austintgriffith/picowallet/pcb/v0/render/pcb.png

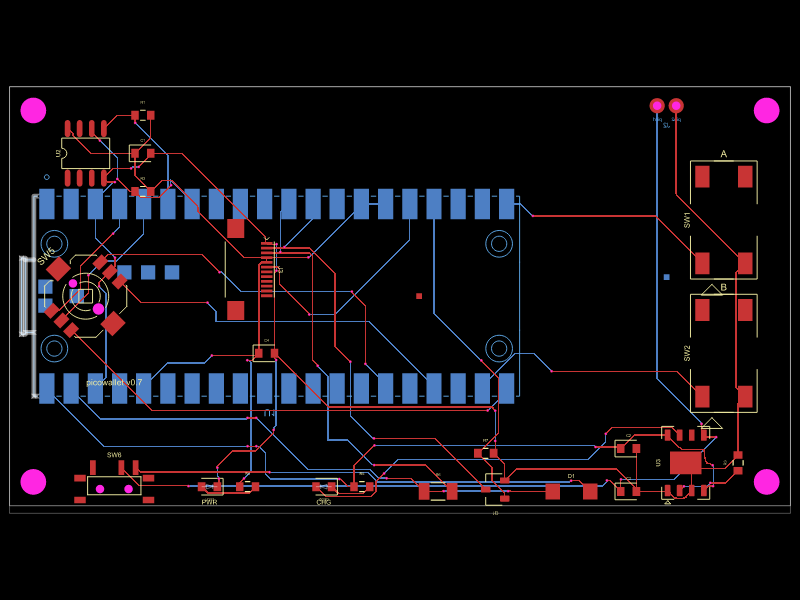
pcb/v0/render/pcb.png
