austintgriffith/picowallet/pcb/COST.md

# picowallet one-board v0.2 — cost + risk (2026-09-23)

Design: `pcb/v0/index.circuit.tsx`. Fab files: `pcb/v0/fab.zip`. Live 3D: see the artifact link in the session.

## Cost, 5 boards (estimate, JLCPCB quote decides)

| Item | Note | USD |
|---|---|---|
| Parts from LCSC | Pico 2 W is $14.20 there (5× = $71). Everything else ~$2.50/board | 84 |
| Bare PCBs | 5 pcs, 2 layer, 64×46 mm | 5 |
| Assembly setup | Parts on both sides = "standard" assembly, $50 flat. One side = $0 | 50 |
| Feeder fees | 6 non-basic part types × $3 | 18 |
| Hand-soldered THT | JST plug + screen header | 6 |
| Shipping | DHL. Slow post ~$10 | 25 |
| **JLCPCB order** | 5 assembled boards | **≈190** |
| Screens | 5× 1.3" ST7789 240×240 module, Amazon | 20 |
| Batteries | 5× 500 mAh LiPo with protection, JST-PH | 30 |
| **Everything** | 5 wallets, ~$48 each | **≈240** |

Cuts: buy Picos at $7 retail and solder them ourselves (−$36). Put only joystick + 2 buttons on the front and hand-solder those (one-sided assembly, −$50). Both → order ≈ $100.

## Confidence: ~80% the first batch runs the firmware with no board fix (net-by-net review 2026-09-23)

Ordered by how much it worries me:
1. ~~Pico footprint mirrored on the back~~ **Checked.** From the back, pin 1 is top-right with USB on the right, same as a real Pico. All 40 labels match the official pinout.
2. ~~Joystick~~ **Checked** (ALPS SKRH datasheet): pin 2 = center, pin 5 = common, both wired right. Directions are diagonal on the body, so SW5 is now at 45°. Up/down/left/right → A/B/C/D is a firmware table; `firmware/keytest.py` finds it.
3. **Screen header order** GND VCC SCL SDA RES DC CS BLK. Clones vary. Check the module you buy.
4. **Slide switch**: pad 2 is the middle pad and is wired as common, standard SPDT. Datasheet PDF blocked, so by geometry + convention.
5. **WiFi**: switch + battery plug sit near the Pico antenna end. Expect range loss, not a dead radio.
6. **No battery protection on board.** Buy protected LiPos. Charge current ~235 mA (R3 = 5.1k) for the 200 mAh 402030 cell.
7. **Thickness** ~17 mm with screen on the front and Pico on the back.
8. Nobody has powered one. Passed tscircuit netlist/placement/shorts only.

## Pins (unchanged from firmware)
LCD DC/CS/SCK/MOSI/RST/BL = GP8/9/10/11/12/13 · A/B = GP15/GP17 · joystick u/d/l/r/press = GP2/18/16/20/3 · ATECC SDA/SCL = GP4/5 · VSYS ← battery via switch + SS14 · TP4056 VCC ← VBUS.

## Net-by-net review 2026-09-23 (v0.4)
Dumped the compiled netlist and checked: all 40 Pico labels vs official pinout; Pico mirror (from the back, USB right, pin 1 top-right, pin 20 top-left = a real Pico rotated USB-right); ATECC608B SOIC-8 (4 GND, 5 SDA, 6 SCL, 8 VCC); TP4056 ESOP-8 (TEMP→GND disables thermistor, CE→VCC enables, PROG 5.1k ≈ 235 mA); SS14 anode←switch, cathode→VSYS (Pico datasheet battery hookup); J1 7-pin GND VCC SCL SDA RES DC BLK; J2 pin1 BAT+. All matched. Independent agent review was started but died on a spend limit before reporting.
