austintgriffith/picowallet/pcb/v0/bom.csv

Designator | Comment | Value | Footprint | JLCPCB Part #
U1 |  | C42394205 | C42394205 | C42394205
J3 |  | C466532 | C466532 | C466532
C4 | 100n | 100n | cap0603 | C14663
R6 | 39 | 39 | res1206 | C25379
Q1 |  | C20917 | sot23w_p1mm_pw0.65mm_pin1location(rightside,bottom) | C20917
R7 | 10k | 10k | res0603 | C25804
SW5 |  | C139794 | C139794 | C139794
SW1 |  | C2837531 | C2837531 | C2837531
SW2 |  | C2837531 | C2837531 | C2837531
U2 |  | C1518769 | C1518769 | C1518769
R1 | 4.7k | 4.7k | res0603 | C23162
R2 | 4.7k | 4.7k | res0603 | C23162
C1 | 100n | 100n | cap0603 | C14663
J2 |  | C131337 | C131337 | C131337
C2 | 10u | 10u | cap0603 | C19702
U3 |  | C725790 | C725790 | C725790
R3 | 12k | 12k | res0603 | C22790
C3 | 10u | 10u | cap0603 | C19702
D1 |  | C2480 | C2480 | C2480
SW6 |  | C431540 | C431540 | C431540
R10 | 100k | 100k | res0603 | C25803
Q2 |  | C15127 | sot23w_p1mm_pw0.65mm_pin1location(rightside,bottom) | C15127
R8 | 100k | 100k | res0603 | C25803
R9 | 10k | 10k | res0603 | C25804
LED1 |  | C12624 | 0603_color(green) | C12624
R4 | 1k | 1k | res0603 | C21190
LED2 |  | C2286 | 0603_color(red) | C2286
R5 | 1k | 1k | res0603 | C21190
