austintgriffith/picowallet/pcb/dossier/img/jlcpcb-bom-v07c.png

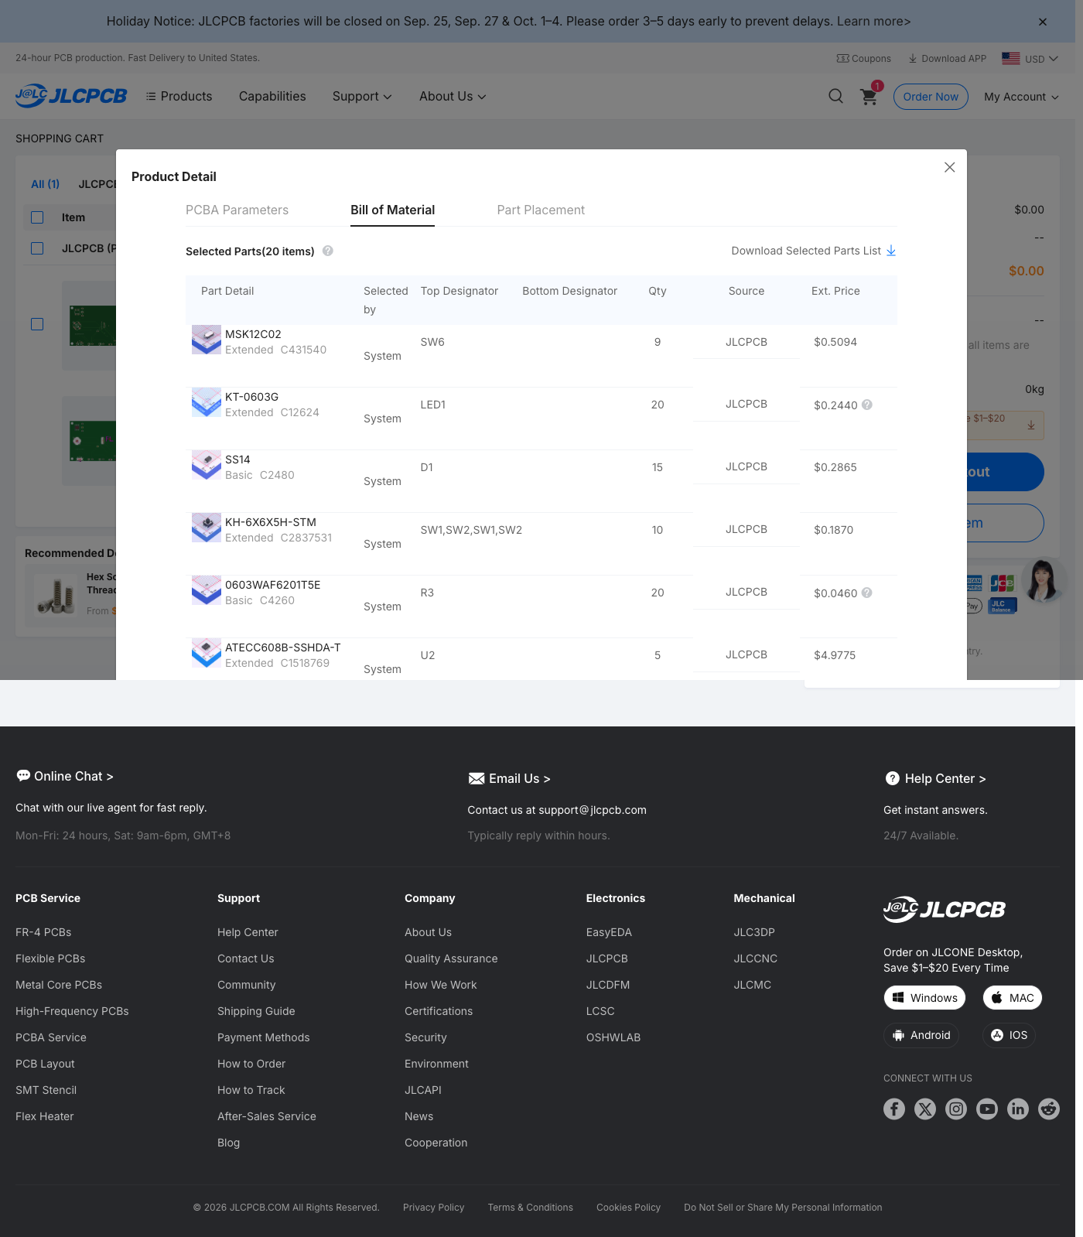
pcb/dossier/img/jlcpcb-bom-v07c.png
