austintgriffith/picowallet/buildlog/wiring-card.html

# Pico wallet: ATECC608 wires (the white/yellow/black/red bag)

The bag of white / yellow / black / red JST cables into the LCD board header, beside the Pico pins. USB at the top. Count down from the USB end.
Look at the Pico side of the sandwich, not the screen side. Checked 2026-09-26: two chips (ATECC608 on 9/14, Trust M on 9/17) answered with exactly this wiring.

Wire | Goes to | Side | From USB end | Pin #
White | GND | Right | 3rd | 38
Yellow | 3V3 OUT | Right | 5th | 36
Black | SDA (GP4) | Left | 6th | 6
Red | SCL (GP5) | Left | 7th | 7

Right side, top down: VBUS, VSYS, GND (white), 3V3_EN, 3V3 (yellow). Skip 1st, 2nd and 4th. Never put a wire in the 4th (3V3_EN): GND there shuts off 3.3 V.

Left side, top down: GP0, GP1, GND, GP2, GP3, GP4 (black), GP5 (red).

Push the bare ends into the LCD board's socket beside the Pico pins. Tug lightly. Jam the breakout flat in the gap.

Bare pins on the Pico itself are in the same order, board face up, USB at top.

Rule: the plug is GND, V+, SDA, SCL from the GND end. This bag colors that white, yellow, black, red. Trust the order, not the colors.
