austintgriffith/picowallet/pcb/dossier/review/KH6X6-manufacturer.pdf

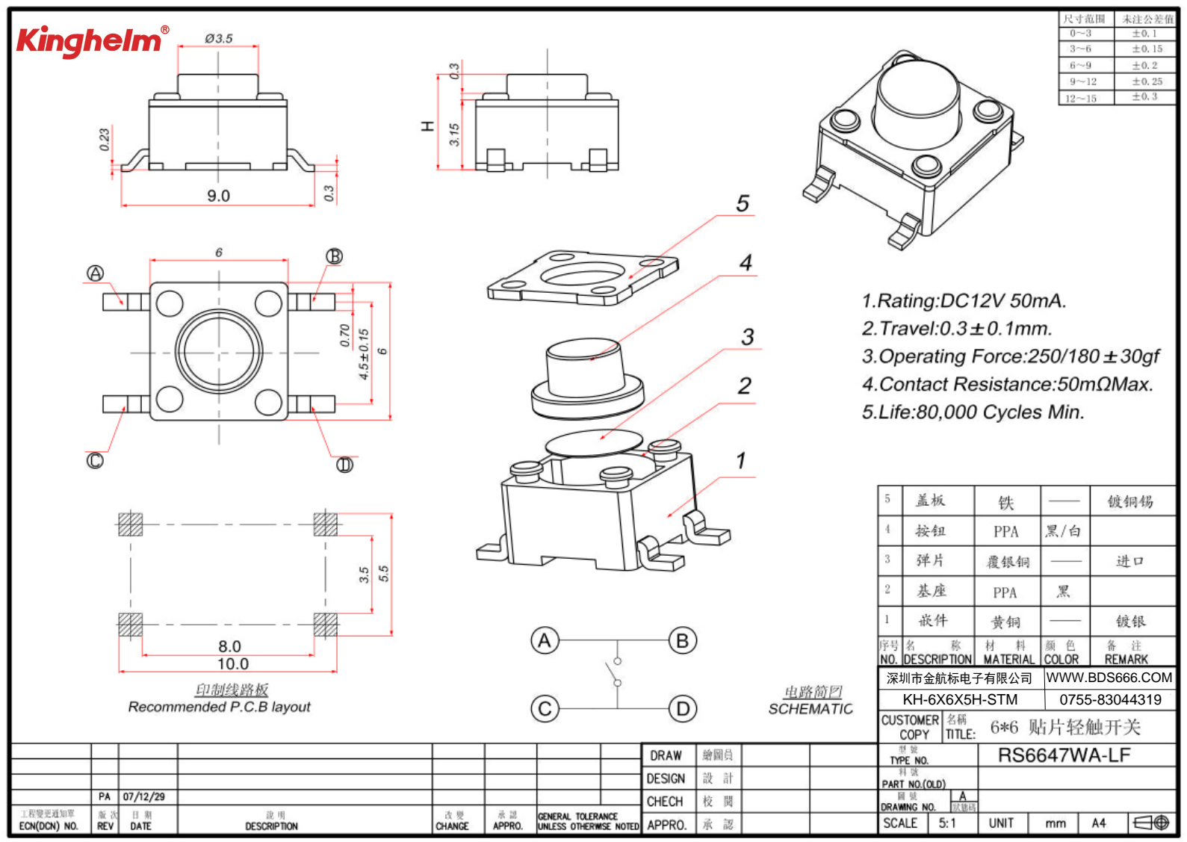
[picture p56: page 1]

深圳市金航标电子有限公司 WWW.BDS666.COM KH-6X6X5H-STM 0755-83044319
