austintgriffith/picowallet/pcb/dossier/review/copper-results.txt

Gerber objects 725
SHORTS 0
OPENS 0
J3 NET J3.1 GND ['U1.3', 'U1.38', 'J3.1', 'J3.12', 'C4.2', 'Q1.2', 'R7.2', 'SW5.5', 'SW1.2', 'SW2.2', 'U2.4', 'C1.2', 'J2.2', 'C2.2', 'U3.1', 'U3.3', 'U3.9', 'R3.2', 'C3.2', 'LED1.1']
J3 NET J3.2  ['U1.12', 'J3.2']
J3 NET J3.3  ['U1.11', 'J3.3']
J3 NET J3.4  ['U1.14', 'J3.4']
J3 NET J3.5  ['U1.15', 'J3.5']
J3 NET J3.6  ['U1.16', 'J3.6']
J3 NET J3.7  ['J3.7']
J3 NET J3.8 V3_3 ['U1.36', 'J3.8', 'J3.9', 'C4.1', 'U2.8', 'R1.2', 'R2.2', 'C1.1', 'R4.1']
J3 NET J3.9 V3_3 ['U1.36', 'J3.8', 'J3.9', 'C4.1', 'U2.8', 'R1.2', 'R2.2', 'C1.1', 'R4.1']
J3 NET J3.10  ['J3.10', 'R6.2']
J3 NET J3.11  ['J3.11', 'Q1.3']
J3 NET J3.12 GND ['U1.3', 'U1.38', 'J3.1', 'J3.12', 'C4.2', 'Q1.2', 'R7.2', 'SW5.5', 'SW1.2', 'SW2.2', 'U2.4', 'C1.2', 'J2.2', 'C2.2', 'U3.1', 'U3.3', 'U3.9', 'R3.2', 'C3.2', 'LED1.1']
J3 NET J3.13  ['J3.13']
J3 NET J3.14  ['J3.14']
Clearances <0.149 mm 43
0.102859 top [(-3.9415034999999996, -1.9111410000000002)] [(-3.9639999999999995, -2.2390000000000008)] ['U1.3', 'U1.38', 'J3.1'] ['J3.10', 'R6.2']
0.103567 top [(8.504393500000004, -14.664729499999995)] [(7.3489999999999975, -13.974000000000002)] ['U1.3', 'U1.38', 'J3.1'] ['U1.17', 'Q1.1', 'R7.1']
0.103861 bottom [(11.189963, -9.689973000000002)] [(10.377763999999997, -11.530716999999997)] ['U1.21', 'SW5.3'] ['U1.22', 'SW2.1']
0.104592 top [(6.4236895, -12.713803499999997)] [(6.9540000000000015, -12.777999999999997)] ['U1.3', 'U1.38', 'J3.1'] ['J3.11', 'Q1.3']
0.104731 bottom [(-34.530037, -9.689973)] [(-33.784088499999996, -13.090095499999997)] ['U1.39', 'R6.1', 'D1.1'] ['U1.40', 'C2.1', 'U3.4']
0.105716 top [(-32.4409075, 5.288795499999998)] [(-32.117, 5.145000000000002)] ['U1.4', 'SW5.1'] ['U1.3', 'U1.38', 'J3.1']
0.108653 top [(-3.0, -1.85)] [(-3.4275399999999996, -2.2071845000000008)] ['J3.11', 'Q1.3'] ['U1.3', 'U1.38', 'J3.1']
0.109792 bottom [(-31.990037000000004, -9.689973)] [(-33.070367000000005, -11.270974)] ['U1.3', 'U1.38', 'J3.1'] ['U1.39', 'R6.1', 'D1.1']
0.110747 top [(2.7464059999999826, -5.37058749999998)] [(-1.541999999999999, -1.5569999999999986)] ['J3.11', 'Q1.3'] ['U1.3', 'U1.38', 'J3.1']
0.113489 top [(-4.824999999999999, -20.0)] [(-5.1191935000000015, -20.66348899999999)] ['U1.40', 'C2.1', 'U3.4'] ['LED2.1', 'R5.2']
0.116818 top [(-3.0, 3.1499999999999995)] [(-3.6005009999999986, 2.9542289999999998)] ['U1.3', 'U1.38', 'J3.1'] ['U1.12', 'J3.2']
0.117378 top [(-3.0, -1.85)] [(-3.6469695, -1.9877550000000015)] ['J3.11', 'Q1.3'] ['U1.3', 'U1.38', 'J3.1']
0.118326 bottom [(-28.282627499999997, 7.202836500000004)] [(-29.625000000000004, 6.346)] ['U1.5', 'SW5.2'] ['U1.4', 'SW5.1']
0.123784 top [(7.062443999999995, -13.301677499999998)] [(6.939000000000003, -13.627999999999995)] ['U1.3', 'U1.38', 'J3.1'] ['J3.11', 'Q1.3']
0.125259 top [(7.3530000000000015, -12.925)] [(6.9540000000000015, -12.777999999999997)] ['U1.17', 'Q1.1', 'R7.1'] ['J3.11', 'Q1.3']
via drill sizes Counter({(0.3, 0.2): 62})
Minimum copper/rectangular edge clearance (0.24990000000000026, 94)
NPTH copper clearance (-31.656823091971688, -1.3435361182731562) [(0.6501637375312815, 31)]
NPTH copper clearance (-34.343715723395576, 1.3433565131507348) [(0.14347321315073483, 444)]
NPTH copper clearance (-31.5, -20.2502) [(1.104747572452157, 89)]
NPTH copper clearance (-28.5, -20.2502) [(0.5358015931360581, 116)]
NPTH copper clearance (-38.5, 19.5) [(2.177749408598903, 62)]
NPTH copper clearance (38.5, 19.5) [(4.642374675631586, 34)]
NPTH copper clearance (38.5, -19.5) [(1.2912740119706192, 83)]
NPTH copper clearance (-38.5, -19.5) [(2.950471998257225, 92)]
Min via hole edge spacing (0.2252175913576484, 'pcb_via_51', 'pcb_via_53')
NPTH closest copper object POLYGON ((-33.18999650000001 -0.7501255, -33.18999650000001 0.7498715, -34.6899935 0.7498715, -34.6899935 -0.7501255, -33.18999650000001 -0.7501255)) ['U1.46']
Via hole to foreign copper <.2 mm 21
(0.15285899999999986, 'pcb_via_56', 229, (-3.964, -2.239), 'top', ['U1.3', 'U1.38'])
(0.15356706537326545, 'pcb_via_50', 271, (7.349, -13.974), 'top', ['U1.3', 'U1.38'])
(0.15459237020598596, 'pcb_via_53', 268, (6.954, -12.778), 'top', ['U1.3', 'U1.38'])
(0.1557159628812923, 'pcb_via_30', 329, (-32.117, 5.145), 'top', ['U1.4', 'SW5.1'])
(0.1607470381618225, 'pcb_via_27', 345, (-1.542, -1.557), 'top', ['J3.11', 'Q1.3'])
(0.16832579811019183, 'pcb_via_49', 609, (-29.625, 6.346), 'bottom', ['U1.5', 'SW5.2'])
(0.17378295281951764, 'pcb_via_54', 270, (6.939, -13.628), 'top', ['U1.3', 'U1.38'])
(0.17524427172281387, 'pcb_via_51', 430, (7.353, -12.925), 'top', ['J3.11', 'Q1.3'])
Confirmed via hole to foreign TRACK violations 17
(0.15285899999999986, 'pcb_via_56', 229, (-3.964, -2.239), 'top', ['U1.3', 'U1.38']) Line(x1=-3.723583, y1=-1.911141, x2=-4.159424, y2=-1.911141, aperture=CircleAperture(unit=<LengthUnit millimeter>, attrs=(), original_number=10, _bounding_box=None, diameter=0.15, hole_dia=None), polarity_dark=True, unit=<LengthUnit millimeter>, attrs={})
(0.15356706537326545, 'pcb_via_50', 271, (7.349, -13.974), 'top', ['U1.3', 'U1.38']) Line(x1=7.183787, y1=-13.344123, x2=9.825, y2=-15.985336, aperture=CircleAperture(unit=<LengthUnit millimeter>, attrs=(), original_number=10, _bounding_box=None, diameter=0.15, hole_dia=None), polarity_dark=True, unit=<LengthUnit millimeter>, attrs={})
(0.15459237020598596, 'pcb_via_53', 268, (6.954, -12.778), 'top', ['U1.3', 'U1.38']) Line(x1=5.878261, y1=-12.168375, x2=6.969118, y2=-13.259232, aperture=CircleAperture(unit=<LengthUnit millimeter>, attrs=(), original_number=10, _bounding_box=None, diameter=0.15, hole_dia=None), polarity_dark=True, unit=<LengthUnit millimeter>, attrs={})
(0.1557159628812923, 'pcb_via_30', 329, (-32.117, 5.145), 'top', ['U1.4', 'SW5.1']) Line(x1=-33.498112, y1=4.231591, x2=-31.383703, y2=6.346, aperture=CircleAperture(unit=<LengthUnit millimeter>, attrs=(), original_number=10, _bounding_box=None, diameter=0.15, hole_dia=None), polarity_dark=True, unit=<LengthUnit millimeter>, attrs={})
(0.1607470381618225, 'pcb_via_27', 345, (-1.542, -1.557), 'top', ['J3.11', 'Q1.3']) Line(x1=-1.428976, y1=-1.195206, x2=6.921788, y2=-9.545969, aperture=CircleAperture(unit=<LengthUnit millimeter>, attrs=(), original_number=10, _bounding_box=None, diameter=0.15, hole_dia=None), polarity_dark=True, unit=<LengthUnit millimeter>, attrs={})
(0.16832579811019183, 'pcb_via_49', 609, (-29.625, 6.346), 'bottom', ['U1.5', 'SW5.2']) Line(x1=-29.655218, y1=5.830246, x2=-26.910037, y2=8.575427, aperture=CircleAperture(unit=<LengthUnit millimeter>, attrs=(), original_number=10, _bounding_box=None, diameter=0.15, hole_dia=None), polarity_dark=True, unit=<LengthUnit millimeter>, attrs={})
