austintgriffith/picowallet/(commit log)

2026-09-15 wallet runs on an RP2040 Pico W: lcd.py allocates the framebuffer at import, main.py and ship import lcd first, ship soft-resets before the run
    On a 264 KB board the 115 KB framebuffer no longer fits once wallet.py has been
    compiled (heap fragmentation), and mpremote's resident copy helpers made it worse.
    Pink USB-C clone now boots the wallet with ~52 KB free.
    [lcd.py, main.py]
2026-09-15 atecc: bus pins from secrets.py (ATECC_SDA/ATECC_SCL, default GP4/GP5); SoftI2C when the pair is not a hardware I2C pair; NO CHIP screen prints the real pins
    For boards where GP5 is taken. The wallet Pico keeps hardware I2C0 on GP4/GP5.
2026-09-15 wallet: start() survives a board with no WiFi chip (net.connect failure is logged, home screen says no wifi)
    [wallet.py]
2026-09-15 buildlog: 2026-09-14 ATECC wiring post-mortem (cable colors white/yellow/black/red = GND/V+/SDA/SCL, clamp-diode false short) + printable wiring card
2026-09-15 USB wallet: usbwallet.py (JSON lines over USB serial, passive device, blockie fingerprint of the digest), blockies.py (pixel-exact port), USB.md protocol; emulator gets serial stdin (SharedArrayBuffe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
2026-09-15 USB wallet: one-press setup (lock + make key) with a plain-words screen before and the new wallet's blockie after; Setup page button for it
2026-09-15 USB wallet: reboot message, so the host never needs mpremote to reset the board
    [usbwallet.py]
2026-09-15 atecc: wake retries with a sleep between rounds; config write in batches of 8 words under the watchdog (first real blank-chip lock worked with this); signer labels which provisioning step failed; web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
    [atecc.py, signer.py]
2026-09-15 atecc: fix the config table (a spare 0xFF row at byte 96 shifted every KeyConfig one slot block down); verify the config zone by read-back before any lock; assert slot 0 is a P-256 GenKey slot at imp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
    [atecc.py]
2026-09-15 atecc: CONFIG fingerprint asserted at import; tools/check_config proves the table against the Pi's proven one; README points at both before any lock
2026-09-17 trustm: OPTIGA Trust M physical layer on GP4/GP5 (retry on NACK, 50us guard time, soft reset) and the datasheet's coprocessor-UID read; first chip answered with UID cd163384...0809
    [trustm.py]
2026-09-17 trustm: IFX I2C link layer (frame numbers, CRC-16 0x8408) and APDU Session with GetDataObject; reads lifecycle, metadata and the factory cert
2026-09-17 TrustMAttest: prove on chain that a P-256 key lives in a real Infineon Trust M (CA-signed factory cert checked with P256, key pulled from the signed bytes); trustm.py gains CalcSign and GetRandom; te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
2026-09-21 CLEARSIGNING.md: research notes on ethereum/ethereum-app, ERC-4527/8213 wire+digests, ERC-7730 clear signing, 5792/7821 batching, and what picowallet should do
2026-09-23 pcb: one-board v0 parts list + pin map, step 1 for approval
2026-09-23 pcb/v0: one-board picowallet in tscircuit — Pico 2 W module, ATECC608B, joystick, ABXY, display header; routed, renders
2026-09-23 pcb/v0: Pico on the back with USB at the edge, screen module drawn on the front, joystick left, ABXY right; 70x40mm
2026-09-23 pcb/v0.2: two buttons, LiPo charger strip (TP4056 + switch + SS14 + JST-PH), 64x46mm; fab.zip + BOM; COST.md with estimate and risks
    [bom.csv]
2026-09-23 pcb/v0.2: joystick at 45° per ALPS datasheet, header + LiPo drawn in 3D; Pico footprint and joystick pins verified, COST.md updated
2026-09-23 pcb/v0.2: LiPo placeholder gets a dot pad so it renders in 3D
2026-09-23 pcb/v0.2: LiPo placeholder renders (doNotPlace hid the model); BOM row is blank, JLCPCB skips it
    [bom.csv]
2026-09-23 pcb: BUILD-PATH.md — what simulation can prove, Colorado/US vs JLCPCB build options with 2026 tariffs
2026-09-23 pcb/v0.3: battery, charger and ATECC moved under the screen; 60x42mm; ORDER.md test-run checklist
    [bom.csv, pick_and_place.csv]
2026-09-23 pcb/v0.3: 68x42, joystick 9mm clear of the screen, flat battery pads outside the screen outline
    [bom.csv, pick_and_place.csv]
2026-09-23 pcb/v0.4: zero-solder build — LCSC 7-pin screen header + JST battery plug placed by JLCPCB, 402030 LiPo under the screen, 68x44
    [bom.csv, pick_and_place.csv]
2026-09-23 pcb/v0.4: charge current 235mA for 200mAh cell; net-by-net review notes
    [bom.csv]
2026-09-23 pcb/v0.4: R3 5.1k gets its own LCSC number (C23186); the auto-pick kept the 2k part
    [bom.csv]
2026-09-23 pcb: JLCPCB test order driven to the checkout address step; real quote $190.83; ORDER.md log + finish steps
2026-09-24 pcb: CASE.md — every part position, height, cutout, and mounting hole for a printed enclosure; board.glb
2026-09-24 pcb/v0.5: power switch overhangs the edge, PWR/CHG LEDs (polarity-checked), CASE.md + ORDER.md shopping list
    [bom.csv, pick_and_place.csv]
2026-09-24 pcb/v0.5: switch flipped, knob overhangs the bottom edge
    [pick_and_place.csv]
2026-09-24 pcb/v0.6: Waveshare 1.3in LCD Module on JST-PH 8-pin socket + 4 standoff holes (true zero-solder screen), 72x44
    [bom.csv, pick_and_place.csv]
2026-09-24 pcb/ref: LCSC 2in bare ST7789 panel (C5329582) photos + datasheet, v1 screen candidate
2026-09-24 pcb/v0.7: bare 2in ST7789 panel on FPC latch + backlight driver, battery to the back, 82x44
    [bom.csv, pick_and_place.csv]
2026-09-24 pcb/v0.7: panel model centered
    [pick_and_place.csv]
2026-09-24 pcb/usb-signer v0.1: ATECC608B + MCP2221A on a USB-C male-plug stick, 40x14x0.8mm, zero-solder
    [bom.csv, pick_and_place.csv]
2026-09-24 pcb: v0.7 uploaded to JLCPCB, $221.55/5 assembled, panel placed by JLCPCB; ORDER.md log
2026-09-24 pcb: cart cleaned, fab_Y3 only
2026-09-24 pcb/v0.7b: Pico to the edge, CPL rotation 180, BT1 stripped; JLCPCB cart fab_Y4 $221.24
    [bom.csv, pick_and_place.csv]
2026-09-24 pcb: REPORT.md — review report for v0.7b
2026-09-25 pcb/usb-signer v0.2: 30x12mm, passives on the back
    [pick_and_place.csv]
2026-09-25 pcb/v0.7c: 1mm latch at flat-ribbon position, 27R/6.2k; full review dossier (design files, JLCPCB renders, datasheets, netlist, fold geometry); cart fab_Y6 $221.37
    [B_Cu.gbr, B_Fab.gbr, B_Mask.gbr, B_Paste.gbr, B_SilkScreen.gbr, Edge_Cuts.gbr, F_Cu.gbr, F_Fab.gbr]
2026-09-25 pcb/usb-signer v0.3: CC on A5 per USB-IF, LED_I2C active-low fix, REPORT.md + datasheets + netlist for review
2026-09-26 emu: re-identify boards after a replug or reflash
    The device list cached each board by port name, and the name comes back the same
    after a reflash, so a board that got MicroPython still showed as the old firmware.
2026-09-26 emu: identify boards from USB info, never interrupt them
    The device list ran mpremote on every newly seen port, which Ctrl-Cs the board.
    Since boards are re-identified after a replug, that stopped the wallet halfway
    through booting. MicroPython reports itself as the USB manufacturer, so use that.
2026-09-26 emu: forget cached boards once per bootloader appearance, not every poll
    While a BOOTSEL drive was mounted, every 3 s poll dropped all cached identities,
    so other boards on USB stayed "identifying" forever.
2026-09-26 Boot logo and loading bar
    boot.py draws the logo first thing (lcd.splash, logo.bin from tools/logo). loader.load(app)
    loads the app's helper files one by one under a plastic-look bar (bar.bin from tools/bar),
    fills it grey, turns it green, and a hard timer wipes it partway through the wait for the
    app's first screen (last boot's wait kept in apptimes.txt on the board). Apps need no
    changes; main.py, main_usb.py and the emulator's boot main.py call the loader.
    lcd.py: backlight off until the first frame is on the panel, later LCD()s keep the logo,
    brightness clamped. tools/push also copies logo.bin and bar.bin. Host test for the panel
    commands. Drops the unused 320x240 board-profile support.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
2026-09-26 Boot logo: store only the box around the logo, not the whole screen
    logo.bin keeps the logo's bounding box (96x77) plus the background colour; splash()
    fills the framebuffer with the colour and reads the box's rows into place. Same pixels
    on screen, 115,200 -> 14,794 bytes of flash.
2026-09-26 Loading bar: store its ends plus the repeated middle column, fill rows only
    bar.bin keeps each piece as left block + middle column + right block, and the grey/green
    fills and the cap only for the 20 track rows they change. loader.py draws each end in one
    write and the middle a row at a time, filled by a viper helper. Same pixels on screen
    (checked in the emulator at every stage), same draw time on the board.
    bar.bin 47,856 -> 11,604 bytes; RAM while loading 37.7 KB -> 15.6 KB.
2026-09-26 lcd: ST7789 minimum timings, frame sent while the panel wakes
    Reset pulse 20 us, commands 5 ms after it, sleep out once 120 ms have passed since the
    reset (the frame goes into panel RAM during that wait), display on 5 ms later. Was
    10+10+120 ms before setup and 120 ms after sleep out. Logo draw 328 -> 145 ms; logo on
    screen 551 -> 364 ms after power-on on the pink board.
    [lcd.py]
2026-09-26 Boot logo from a small splash.py, before lcd.py is loaded
    splash.py holds the pins and ST7789 setup and draws logo.bin straight to the panel (flat
    background, then the logo's box), no framebuffer. boot.py runs it before anything else;
    lcd.py reuses its setup and keeps the logo once the panel is up; loader.py takes the
    background colour from it. Logo on screen 364 -> 293 ms after power-on on the pink board.
2026-09-26 Bootloader modules pre-compiled to .mpy
    tools/mpy compiles splash, lcd and loader with mpy-cross (armv6m, loads on RP2040 and
    RP2350). tools/push and the emulator's send copy the .mpy and delete the .py on the board;
    the send falls back to the .py if it was edited after the .mpy was built. On the pink
    board: preparing splash/lcd/loader 121/117/285 -> 46/28/49 ms, logo on screen 293 -> 215 ms
    after power-on, bootloader files 45 -> 34 KB.
2026-09-26 Loader preloads only unconditional imports; push rebuilds .mpy; README install
    loader._imports skips indented import lines (inside try/if): the app handles those, and one
    meant to fail no longer stops startup. tools/push runs tools/mpy first so an edited .py is never
    shadowed by old bytecode, or sends the .py when mpy-cross is missing. README's first install
    copies the .mpy and the logo/bar art and removes the three bootloader .py.
    [loader.py]
2026-09-26 wiring card: say which side to look at, warn off 3V3_EN, note the two verified chips
2026-09-26 factory test page: detects board and secure chip, checks screen and all nine buttons over WebSerial
2026-09-26 factory: serve https on the LAN (self-signed), link the wiring guide
2026-09-26 PCB v0.8/v0.9 review work, mainnet deploy records, emu wire sketches, handoff notes
    [bom.csv, pick_and_place-UNVERIFIED.csv, pick_and_place.csv]
2026-09-26 ups sketch: battery %, volts, current and USB state from the Pico-UPS-B hat
2026-09-26 Rename ups sketch to battery
2026-09-26 battery sketch: update its name in comments and output
2026-10-03 Reports: narrow the ATECC laser claim, say which chips the firmware supports, clarify the soft-key gap
